all-rib/tcc/new-src/18-conclusao.tex

\chapter{Conclusão}\label{cap:conclusoeseperspectivas}

O sistema num geral apresentou diversos problemas, e cada um deles foi
abordado individualmente. O projeto portanto contribuiu de maneira
significativa para registro, e sugestão de abordagens para a
respectiva solução.

A plataforma estabelecida permite a integração de uma grande gama de
sensores, desde que utilizadores do protocolo I²C, e com uma
arquitetura compatível à biblioteca HERMES.

Além disso, os testes realizados, apesar de prematuros, evidenciou
falhas intrinsecas na forma de conexão dos sensores, bem como do
contato entre material orgânico e o hardware. Mais testes de
impermeabilização são necessários, bem como de diferentes aparatos para o correto
posicionamento, seja alterando a caixa, ou alterando o encapsulamento.

Todas as soluções foram documentadas e estão disponíveis publicamente
em repositório pessoal de \cite{Allan2025}.
