all-rib/tcc/new-src/19-referencias.tex

[1] Brown-2001 - Responding to Deforestation: Productive Conservation,
the World Bank, and Beekeeping in Rondonia, Brazil*

[2] https://abelha.org.br/atlas-da-apicultura-no-brasil/

[3] https://www.fao.org/faostat/en/#data/QCL

[4] machado-2024 - UTILIZAÇÃO DE TECNOLOGIA DE PRECISÃO NA APICULTURA:
UMA REVISÃO SISTEMATICA, PAULA ARAUJO MACHADO

[5]
http://apisenterprises.com/papers_htm/ABJ/Beekeeping%20in%20Brazil_full.htm

[6] Beginer's bee book  

[7] https://abelhas.org/Mapa?cd
https://abelha.org.br/abelhas-sem-ferrao-do-brasil/
[8]https://abelha.org.br/abelhas-e-producao-de-alimentos-no-brasil/
mapa de abelhas no brasil

[9] https://www.embrapa.br/meio-ambiente/abelhas-nativas/abelhas-e-plantas
Lista extensiva de de abelhas brasileiras, e curiosidades.

[10] http://dx.doi.org/10.7769/gesec.v13i3.1
Revista que mostra dados sobre apicultura

[11] https://www.sciencedirect.com/science/article/pii/S0304380013002895
Modelagem dinâmica de uma colmeia

[12] https://hackaday.io/project/1741-honeybee-hive-monitoring/details
Sujeito que monitorou o peso de uma colmeia

[13] https://lume.ufrgs.br/handle/10183/276197

artigo que revisa algumas coisas sobre AP

[14] https://www.grap.udl.cat/en/presentacio/que-fem/definicions-agricultura-de-precisio/

[15] https://www.i2c-bus.org/i2c-primer/common-problems/

[16] https://github.com/all-rib/hermes

[17] lilygo datasheet
https://github.com/Xinyuan-LilyGO/LilyGo-LoRa-Series:w

[18] https://docs.espressif.com/projects/esp-idf/en/stable/esp32/api-reference/system/log.html
	Lista de coisas sobre como funciona o log no esp32

[19] - https://cdn.sparkfun.com/datasheets/Sensors/Temp/DS18B20.pdf
datasheet ds18b20

[20] - https://sensirion.com/media/documents/213E6A3B/63A5A569/Datasheet_SHT3x_DIS.pdf
datasheet sht30

[21] - https://www.mouser.com/datasheet/2/758/DHT11-Technical-Data-Sheet-Translated-Version-1143054.pdf

datasheet dht11

[22] - https://invensense.tdk.com/wp-content/uploads/2015/02/INMP441.pdf

datasheet inmp441

[24] - https://www.bosch-sensortec.com/media/boschsensortec/downloads/datasheets/bst-bme280-ds002.pdf
datasheet bme280

[23] - https://www.nxp.com/docs/en/user-guide/UM10204.pdf
i2c specification
