all-rib/tcc/new-src/README.tex

Geralmente um TCC tem alguns capítulos bem definidos:

Introdução

Conceitos

Revisão de literatura/Trabalhos relacionados

Proposta

Metodologia

Experimento e Resultados

Conclusões
