all-rib/tcc/new-src/04-agradecimentos.tex

\begin{agradecimentos}

Obrigado à Deus pela oportunidade de realizar, ainda que incerto de quê.

Ao Francisco, meu avô. Os muros que ele levantou não cabem nessas folhas.

Aos meus orientadores, pela paciência monastérica do meu retorno.

À minha namorada, pela compreensão e apoio, piadas e broncas.

E aos meus amigos, à Ernane Carreira, e à todos os que não mencionei, fielmente lembrados em mente coração.

\end{agradecimentos}
