all-rib/tcc/new-src/05-epigrafe.tex

\begin{epigrafe}

%Espaço destinado à epígrafe (elemento opcional). Nesta folha, o(a) autor(a) usa uma citação, seguida de indicação de autoria e ano, relacionada, preferencialmente, com o assunto tratado no corpo do trabalho. A citação deverá constar na lista de referências. Exemplo: 
%
''Se é pra dois, ou três... Então é pra mim!'' \cite{Filho2021}.

%''Então... Não tem final da história...'' \cite{Candido2002}.

\end{epigrafe}
