all-rib/tcc/old-src/main.tex

%%%% main.tex, 2022/08/10, 2.5
%%%% Copyright (C) 2020 Vinicius Pegorini (vinicius@utfpr.edu.br)
%%
%% This work may be distributed and/or modified under the conditions of the
%% LaTeX Project Public License, either version 1.3 of this license or (at your
%% option) any later version.
%% The latest version of this license is in
%%   http://www.latex-project.org/lppl.txt
%% and version 1.3 or later is part of all distributions of LaTeX version
%% 2005/12/01 or later.
%%
%% This work has the LPPL maintenance status `maintained'.
%%
%% The Current Maintainer of this work is Vinicius Pegorini.
%%
%% This work consists of the files utfprpb.cls, utfprpb.tex, and
%% utfprpb-dados.tex.
%%
%% The Current Maintainer of this work is Vinicius Pegorini.
%% Updated by:
%% - Marco Aurélio Graciotto Silva;
%% - Rogério Aparecido Gonçalves;
%% - Luiz Arthur Feitosa dos Santos.
%%
%% This work consists of the files utfpr.cls, main.tex, and
%% variaveis.tex.
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

%###################################################

% Luiz - pdfa: inclusão do pdfa
\PassOptionsToPackage{
	pdfa
}{hyperref}

%% Classe e opções de documento
\documentclass[%% Opções
%% -- Opções da classe memoir --
  12pt,%% Tamanho da fonte: 10pt, 11pt, 12pt, etc.
  a4paper,%% Tamanho do papel: a4paper (A4), letterpaper (carta), etc.
  % fleqn,%% Alinhamento das equações à esquerda (comente para alinhamento centralizado)
  % leqno,%% Numeração das equações no lado esquerdo (comente para lado direito)
  oneside,%% Impressão dos elementos textuais e pós-textuais: oneside (anverso) ou twoside (anverso e verso, se mais de 100 p.)
  openright,%% Impressão da primeira página dos capítulos: openright (anverso), openleft (verso) ou openany (anverso e verso)
%% -- Opções da classe abntex2 --
  sumario = abnt-6027-2012,%% Formatação do sumário: tradicional (estilo tradicional) ou abnt-6027-2012 (norma ABNT 6027-2012)
  chapter = TITLE,%% Títulos de capítulos em maiúsculas (comente para desabilitar)
  % luiz - comentar section para ser minusculo
  %section = TITLE,%% Títulos de seções secundárias em maiúsculas (comente para desabilitar)
  % subsection = TITLE,%% Títulos de seções terciárias em maiúsculas (comente para desabilitar)
  % subsubsection = TITLE,%% Títulos de seções quartenárias em maiúsculas (comente para desabilitar),
%% -- Opções da classe utfprpgtex --
  pretextualoneside,%% Impressão dos elementos pré  -textuais: pretextualoneside (anverso) ou pretextualtwoside (anverso e verso)
  fontetimes,%% Fonte do texto: fontetimes (times), fontearial (arial) ou fontecourier (courier)
  % vinculoscoloridos,%% Cores nos vínculos (citações, arquivos, links, url, etc.) (comente para desabilitar)
  semrecuonosumario,%% Remoção do recuo dos itens no sumário (comente para adição do recuo, se estilo tradicional)
  usemakeindex,%% Compilação de glossários e índices utilizando makeindex (comente para desabilitar)
  % legendascentralizadas,%% Alinhamento das legendas centralizado (comente para alinhamento à esquerda)
  %aprovacaoestiloppg,%% Folha de aprovação do programa de pós-graduação no estilo do PPG (comente para estilo padrão)
  pardeassinaturas,%% Assinaturas na folha de aprovação em até duas colunas (comente para em uma única coluna)
  % linhasdeassinaturas,%% Linhas de assinaturas na folha de aprovação (comente para remover as linhas)
%% -- Opções do pacote babel --
  english,%% Idioma adicional para hifenização
  french,%% Idioma adicional para hifenização
  spanish,%% Idioma adicional para hifenização
  brazil,%% Idioma principal do documento (último da lista)
]{utfpr}%% Classe utfpr

% Luiz: pdfa: necessário para criar pdfa
\usepackage[a-3b,mathxmp]{pdfx}[2018/12/22] % você pode escolher entre a-1b, a-2b, a-3b - o template ainda não suporta o a-Xa de 

\input{configuracoes}

%% Arquivo de dados do modelo de documento LaTeX para produção de trabalhos acadêmicos da UTFPR
\input{./variaveis}%% Realize as modificações pertinentes no arquivo "utfprpb-dados.tex"

%% Ferramenta para criação de índices
\makeindex%% Não comente esta linha

%% Ferramenta para criação de glossários
\makeglossaries%% Não comente esta linha
\include{./PreTexto/entradas-siglas}%% Entradas da lista de abreviaturas e siglas - Comente para remover este item
\include{./PosTexto/entradas-glossario}%% Entradas do glossário - Comente para remover este item

%% Ferramenta para criação de nomenclaturas
\makenomenclature%% Não comente esta linha

%% Início do documento
\begin{document}%% Não comente esta linha

%% Formatação de páginas de elementos pré-textuais
\pretextual%% Não comente esta linha

%% Capa
%\incluircapa%% Comente para remover este item
\coverpageone

%% Folha de rosto (* coloca a ficha bibliográfica no verso)
%\incluirfolhaderosto*%% Comente para remover este item
\coverpagetwo

% luiz - iniciar contagem depois da folha de rosto
\clearpage
\setcounter{page}{2}

%% Ficha catalográfica (teses e dissertações)
%\incluirfichacatalografica%% Comente para remover este item

%% Errata
%\include{./PreTexto/errata}%% Comente para remover este item

%% Folha de aprovação
%\incluirfolhaaprovacao
\approvalpage
%\incluirfolhadeaprovacao%% Para adicionar no formato de texto
%\includepdf[scale=1.0,pages=1]{./PreTexto/folha-aprovacao.pdf} % para adicionar o pdf enviado pelo professor apenas substitua o documento folha-aprovacao.pdf dentro da pasta PreTexto

%% Dedicatória
\include{./PreTexto/dedicatoria}%% Comente para remover este item

%% Agradecimentos
\include{./PreTexto/agradecimentos}%% Comente para remover este item

%% Epígrafe
\include{./PreTexto/epigrafe}%% Comente para remover este item

%% Resumo
\include{./PreTexto/resumo}%% Comente para remover este item

%% Abstract
\include{./PreTexto/abstract}%% Comente para remover este item

%% Lista de algoritmos
%\incluirlistadealgoritmos%% Comente para remover este item

%% Lista de Ilustrações
%% Figuras, Gráficos, Quadros e Fotografias são incluídos juntos em uma mesma lista
%% Na UTFPR sugere-se adotar listas próprias, conforme a natureza da ilustração, a partir da existência de 3 elementos da mesma natureza.Neste caso, cada lista deverá iniciar em folha distinta. Não criar listas com apenas um item.

\incluirlistadeilustracoes

%% Lista de figuras
%\incluirlistadefiguras%% Comente para remover este item

%\incluirlistageraldeilustracoes
%\listofgeneralilust

%% Lista de Fotografias
%\incluirlistadefotografias %% Comente para remover este item

%% Lista de Gráficos
%\incluirlistadegraficos %% Comente para remover este item

%% Lista de tabelas
%\incluirlistadetabelas%% Comente para remover este item

%% Lista de quadros
%\incluirlistadequadros

%% Listagem de códigos fonte
%\incluirlistadecodigosfonte

%% Lista de abreviaturas, siglas e acrônimos
%\incluirlistadeacronimos{glossaries}%% Opções: "glossaries" (pacote) ou "file" (arquivo) ou "none" (desabilita)

%% Lista de símbolos
%\incluirlistadesimbolos{file}%% Opções: "nomencl" (pacote) ou "file" (arquivo) ou "none" (desabilita)

%% Sumário
\incluirsumario%% Comente para remover este item

%% Formatação de páginas de elementos textuais
\textual%% Não comente esta linha

%% Parte
% \part{Introdução}%% Comente para remover este item

%% Capítulo introdução - obrigatório
\include{./capitulos/cap-introducao}%% Comente para remover este item

%% Capítulo
\include{./capitulos/cap-conceitos}%% Comente para remover este item

%% Capítulo
\include{./capitulos/cap-trabalhos-relacionados}%% Comente para remover este item

%% Capítulo
\include{./capitulos/cap-proposta}%% Comente para remover este item

%% Capítulo
\include{./capitulos/cap-metodologia}%% Comente para remover este item

%% Capítulo
\include{./capitulos/cap-experimentos-resultados}%% Comente para remover este item

%% Capítulo - esse capítulo contém exemplos para melhor uso do modelo Latex
%% Na versão final do TCC esse capítulo deve ser removido utilizando o sinal %
%\include{./capitulos/cap-exemplo}%% Comente para remover este item

%% Parte
% \part{Conclusão}%% Comente para remover este item

%% Capítulo
\include{./capitulos/cap-conclusoes}%% Comente para remover este item

%% Capítulos após este comando criam marcadores do pdf na raiz
% \phantompart%% Comente para remover este item

%% Formatação de páginas de elementos pós-textuais
\postextual%% Não comente esta linha

%% Arquivos de referências
\arquivosdereferencias{%% Arquivos bibtex sem a extensão .bib e separados por vírgula - Não comente esta linha
  %./PosTexto/exemplos-referencias,%% Arquivo de referências - Comente para remover este item
  main%% Arquivo de referências - Comente para remover este item
}%% Não comente esta linha

%% Glossário
%\incluirglossario %% Comente para remover este item

%% Arquivos de apêndices
 \begin{arquivosdeapendices}%% Os arquivos de apêndices devem se incluídos neste ambiente - Não comente esta linha
%   %\partapendices%% Página de início dos apêndices - adiciona uma página com o título Apêndices
%   %% Capítulo de exemplo
   \include{./PosTexto/apendicea}%% Apêndice - Comente para remover este item
   \include{./PosTexto/apendiceb}%% Apêndice - Comente para remover este item
 \end{arquivosdeapendices}%% Não comente esta linha

% \begin{apendicesenv}%% Ambiente apendicesenv

% \partapendices
% \chapter{Ola}

% \lipsum[55-56]

% \end{apendicesenv}

%% Arquivos de anexos
\begin{arquivosdeanexos}%% Os arquivos de anexos devem se incluídos neste ambiente - Não comente esta linha
  %\partanexos%% Página de início dos anexos - adiciona uma página com o título Anexos

  \include{./PosTexto/anexoa}%% Anexo - Comente para remover este item
  \include{./PosTexto/anexob}%% Anexo - Comente para remover este item
\end{arquivosdeanexos}%% Não comente esta linha

%% Índice - Adiciona um índice remissivo.
%\incluirindice%% Comente para remover este item

%% Fim do documento
\end{document}%% Não comente esta linha
