all-rib/tcc/old-src/PreTexto/dedicatoria.tex

%%%% DEDICATÓRIA
%%
%% Texto em que o autor presta homenagem ou dedica seu trabalho.

\begin{dedicatoria}%% Ambiente dedicatoria

%Espaço destinado à dedicatória (elemento opcional). Folha que contém o oferecimento do trabalho à determinada pessoa ou pessoas. Exemplo:

Dedico este trabalho à Deus, e à minha família, à minha namorada, e amigos.

\end{dedicatoria}
