all-rib/tcc/old-src/figuras/foto1-eps-converted-to.pdf

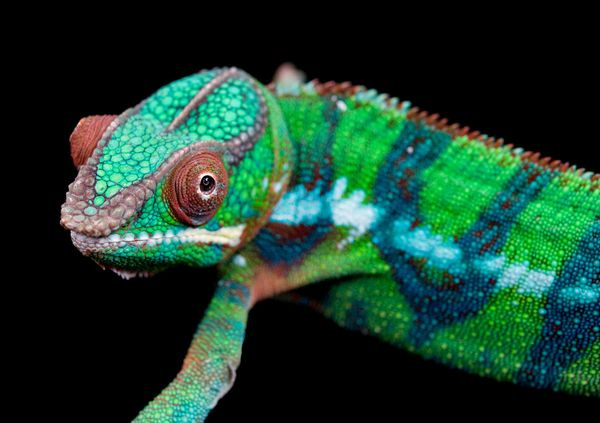
[picture p2: page 1]
