all-rib/tcc/old-src/figuras/grafico2-eps-converted-to.pdf

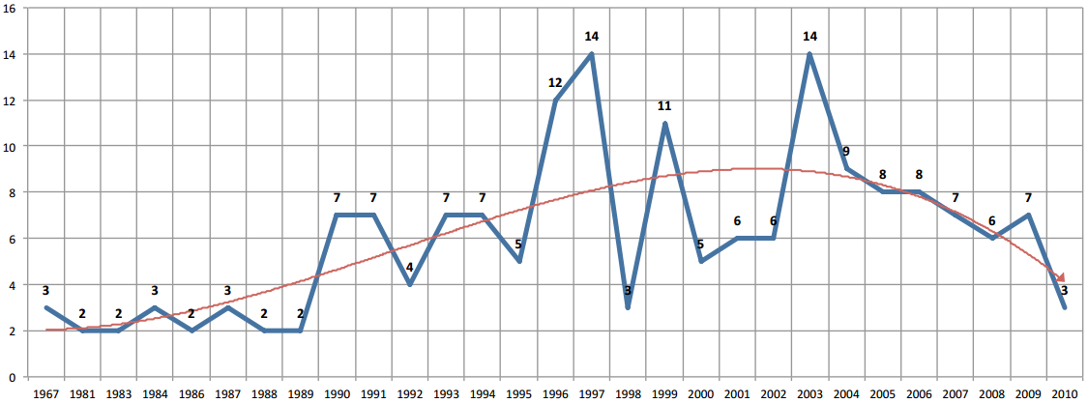
[picture p3: page 1]
