all-rib/tcc/old-src/PreTexto/arquivos/licencasCC/by-eps-converted-to.pdf

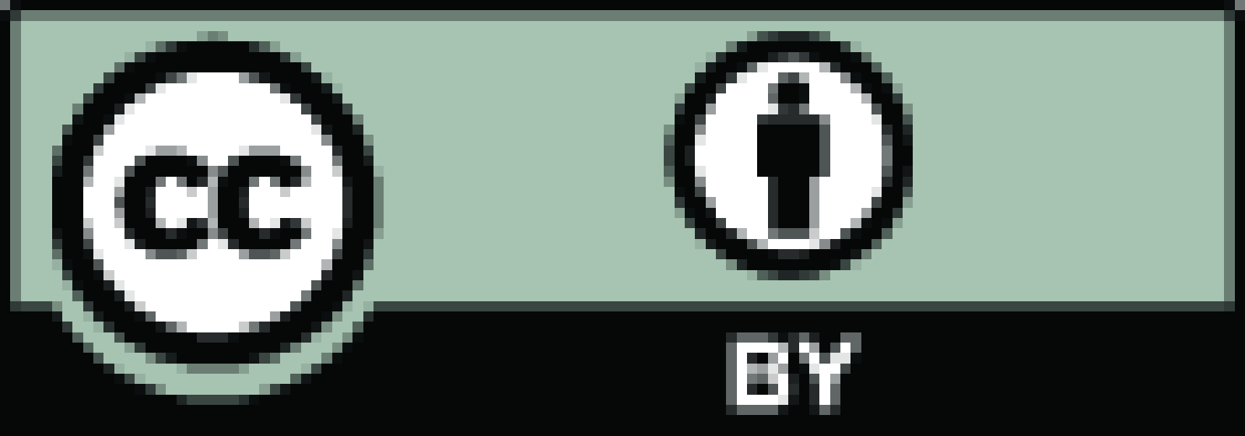
[picture p4: page 1]
