all-rib/tcc/docs/angustula.JPG

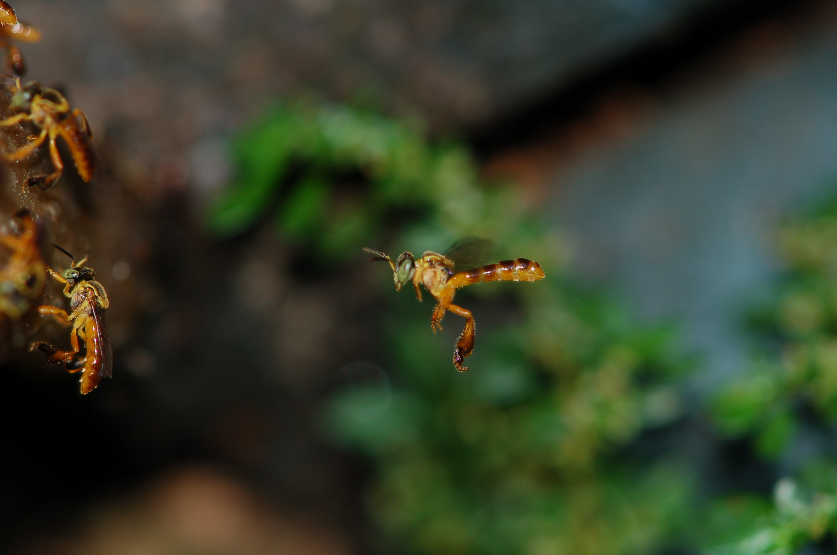
docs/angustula.JPG
