all-rib/tcc/docs/arquitetura.png

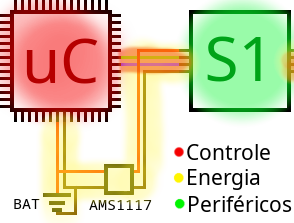
docs/arquitetura.png
