all-rib/tcc/docs/bme280.png

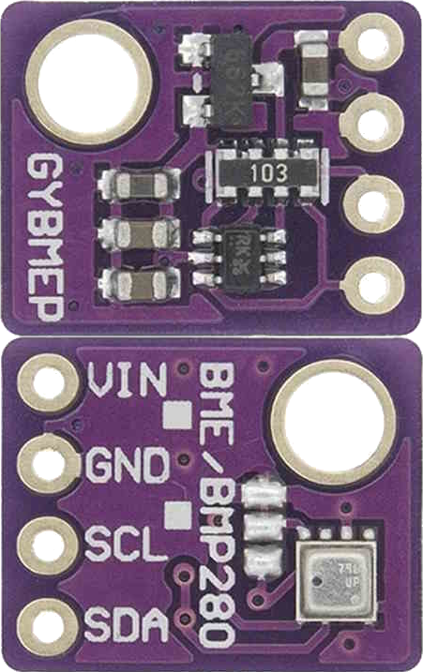
docs/bme280.png
