all-rib/tcc/docs/dht11.png

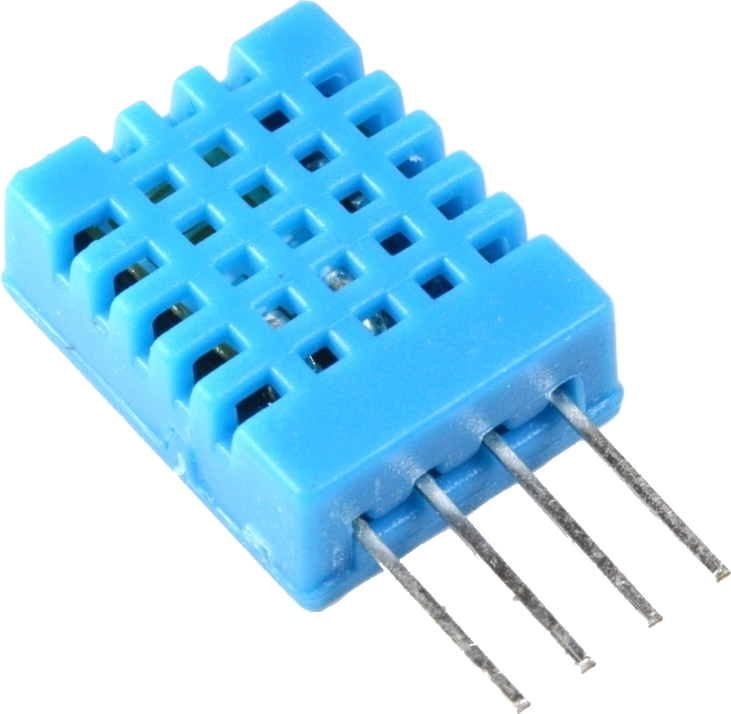
docs/dht11.png
