all-rib/tcc/docs/ds18b20.png

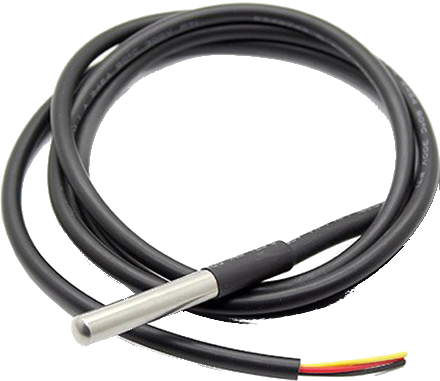
docs/ds18b20.png
