all-rib/tcc/docs/hermes.png

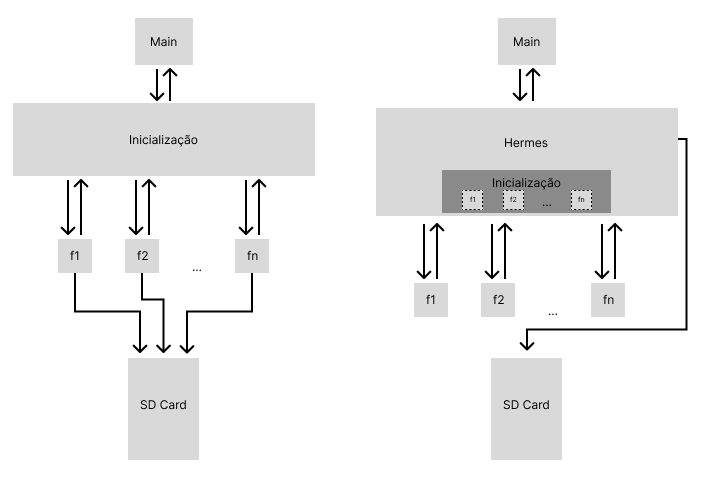
docs/hermes.png
