all-rib/tcc/docs/i2c-1.png

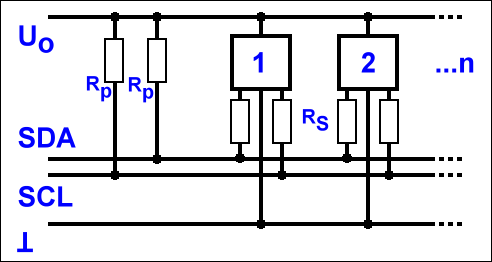
docs/i2c-1.png
