all-rib/tcc/docs/inmp441.png

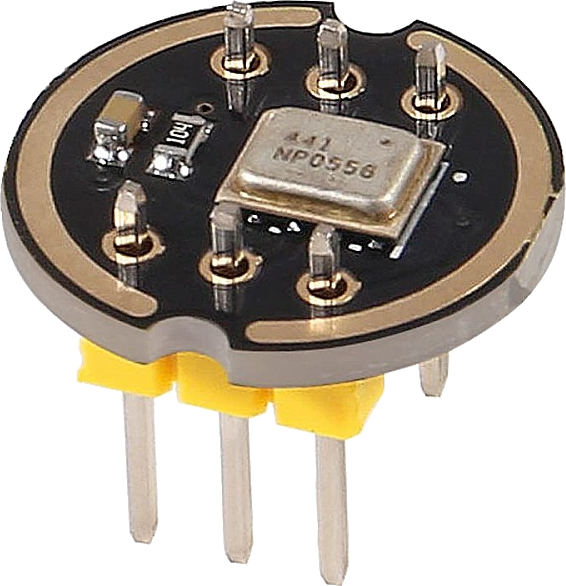
docs/inmp441.png
