all-rib/tcc/docs/jatai.png

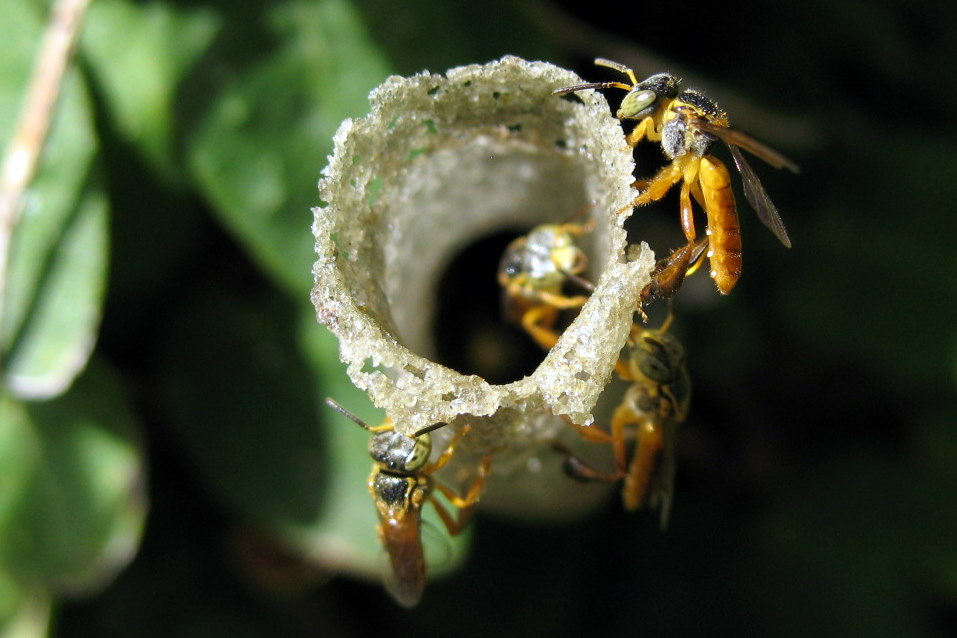
docs/jatai.png
