all-rib/tcc/docs/lora32.png

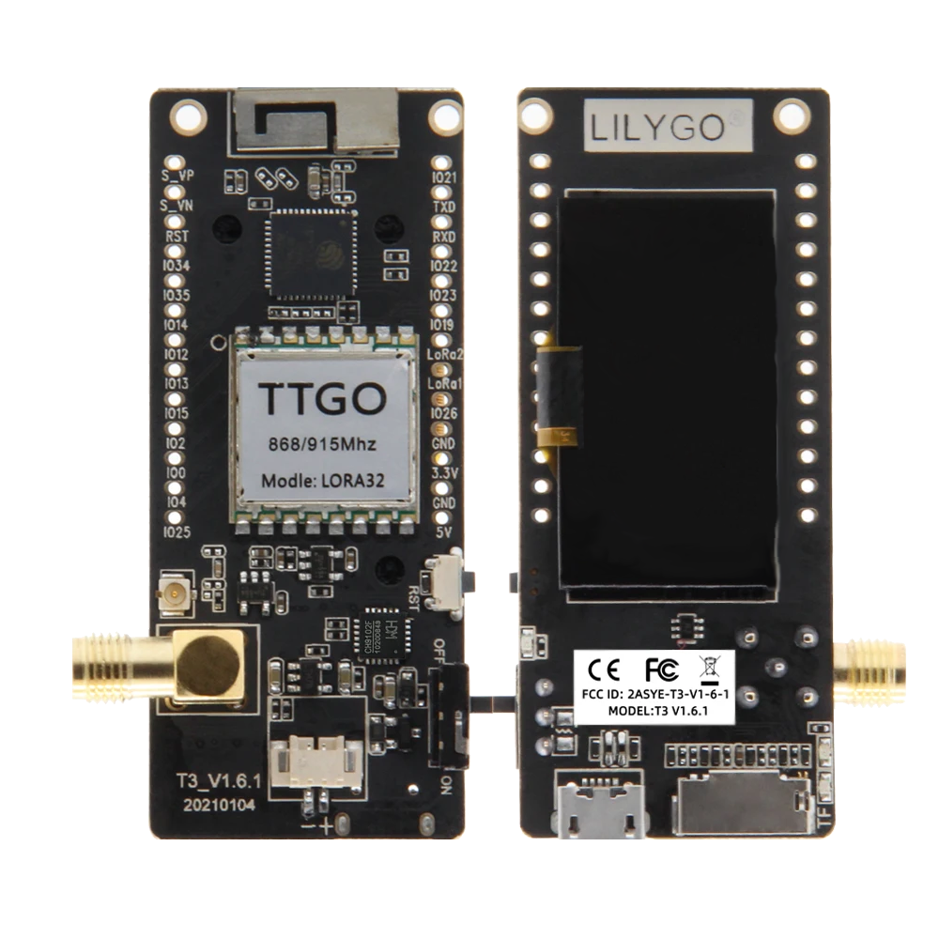
docs/lora32.png
