all-rib/tcc/docs/sen-cob.png

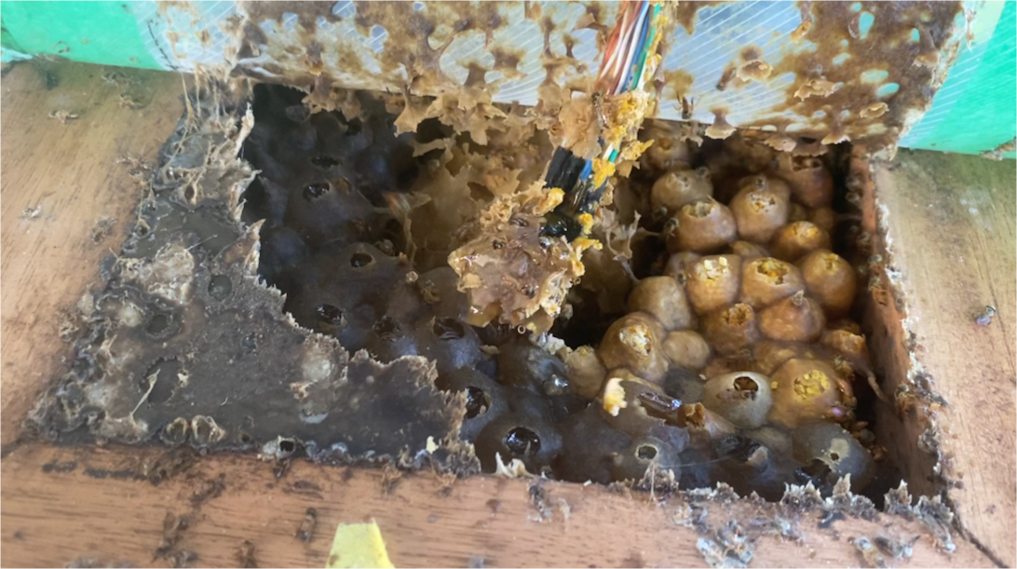
docs/sen-cob.png
