all-rib/tcc/docs/sht30.png

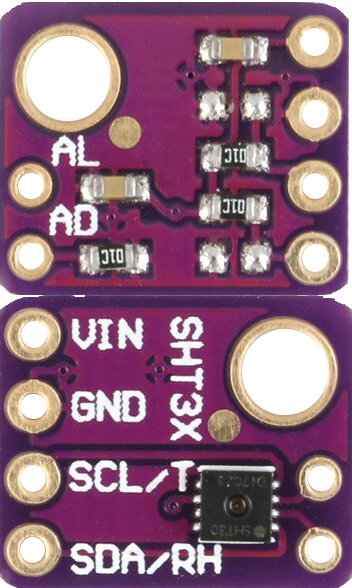
docs/sht30.png
