all-rib/tcc/docs/topologia.png

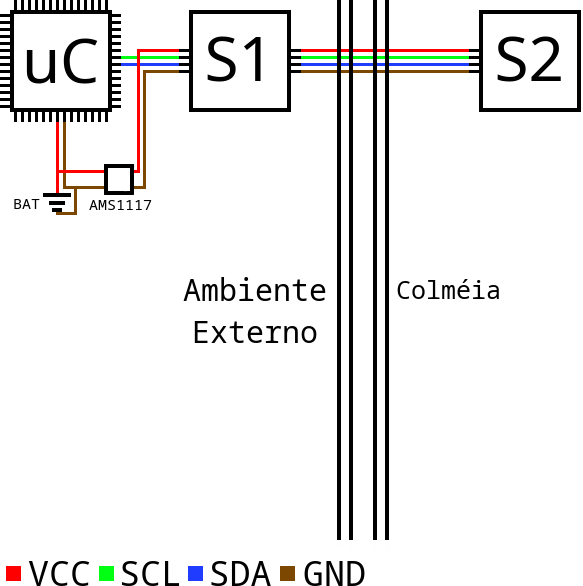
docs/topologia.png
