all-rib/tcc/midia/ilustracao fila.jpg

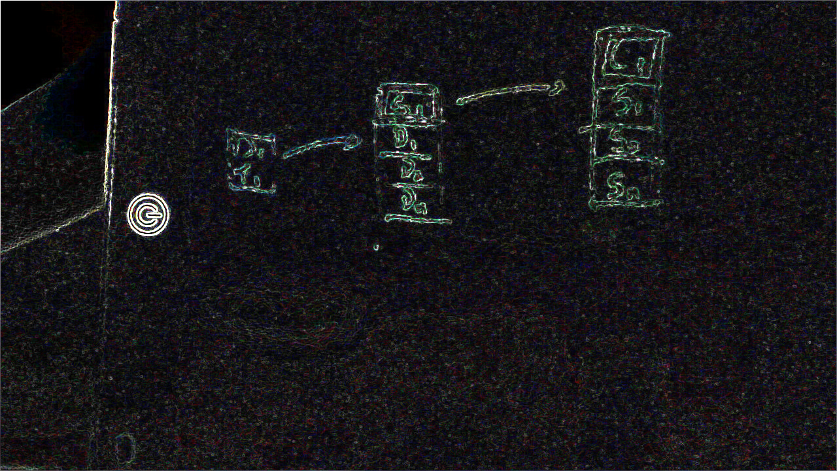
midia/ilustracao fila.jpg
