all-rib/tcc/midia/Tcc/1 - colmeia 2.JPG

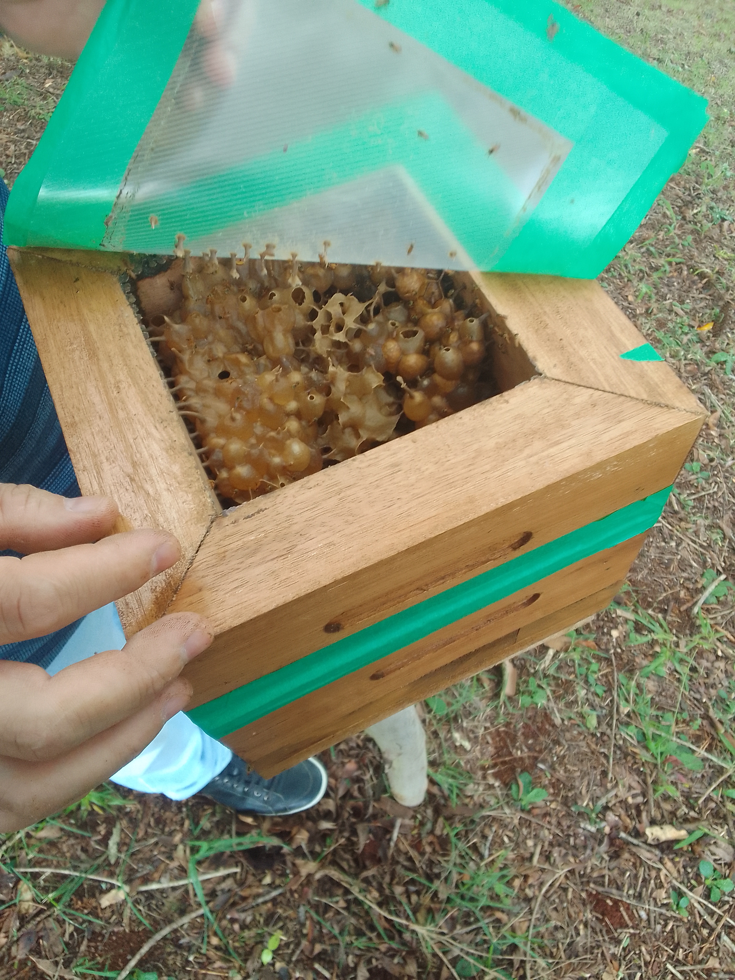
midia/Tcc/1 - colmeia 2.JPG
