all-rib/tcc/midia/Tcc/1 - colmeia 3.JPG

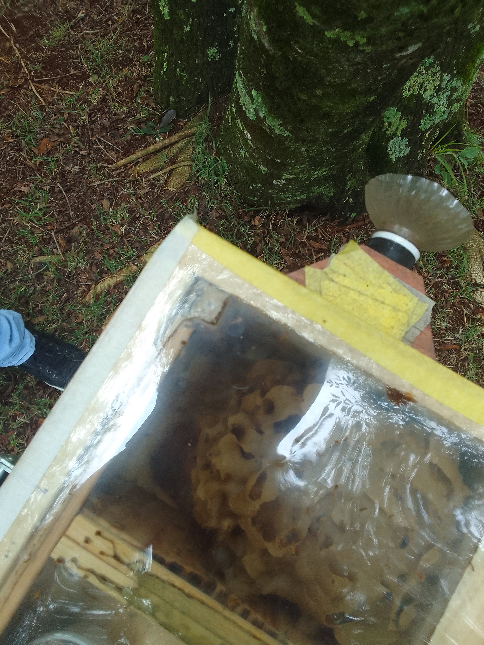
midia/Tcc/1 - colmeia 3.JPG
