all-rib/tcc/midia/Tcc/1 - colmeia 4.JPG

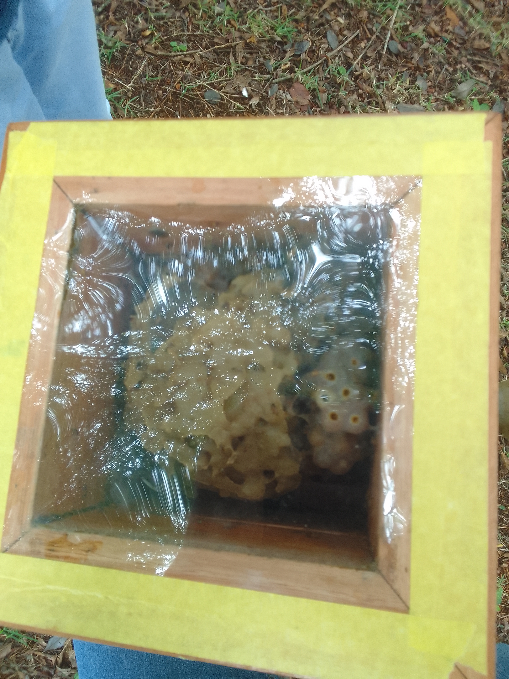
midia/Tcc/1 - colmeia 4.JPG
