all-rib/tcc/midia/Tcc/1 - colmeia 6.JPG

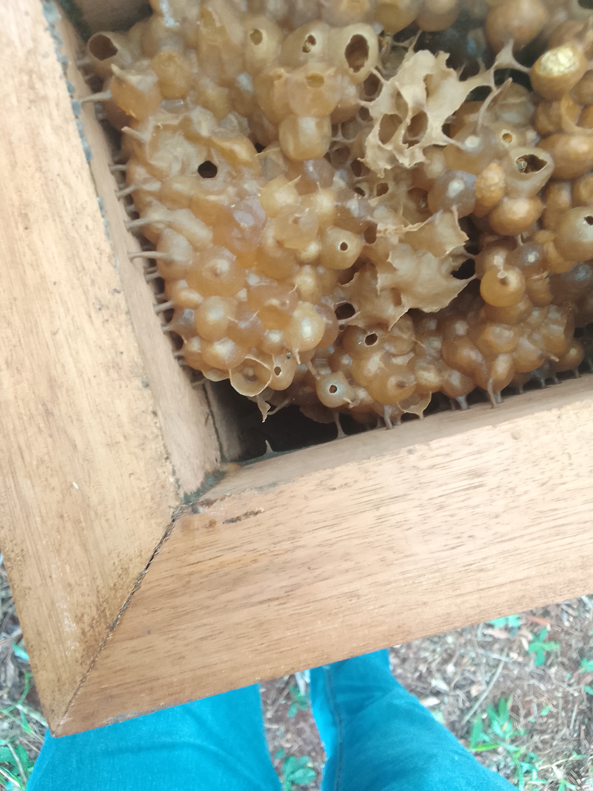
midia/Tcc/1 - colmeia 6.JPG
