all-rib/tcc/midia/Tcc/1 - conector.JPG

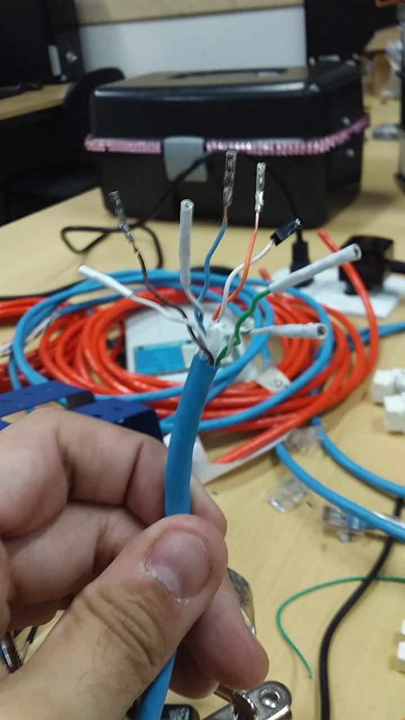
midia/Tcc/1 - conector.JPG
