all-rib/tcc/midia/Tcc/1 - lora.JPG

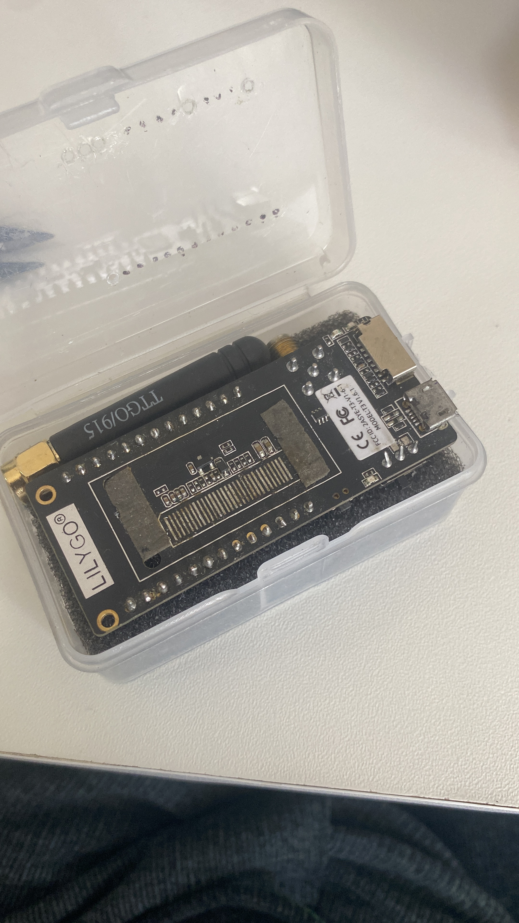
midia/Tcc/1 - lora.JPG
