all-rib/tcc/midia/Tcc/2 - colmeia 1.png

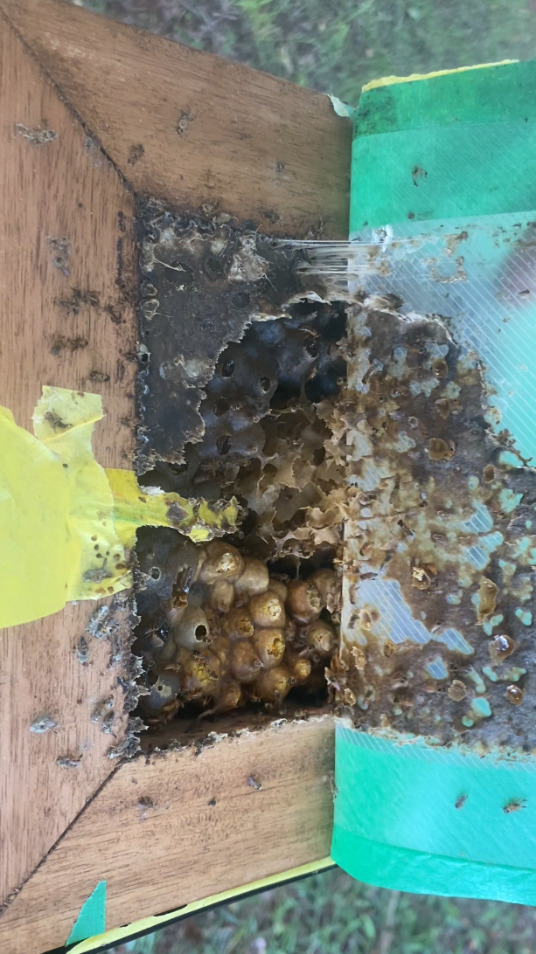
midia/Tcc/2 - colmeia 1.png
