all-rib/tcc/midia/Tcc/2 - sensor 3.png

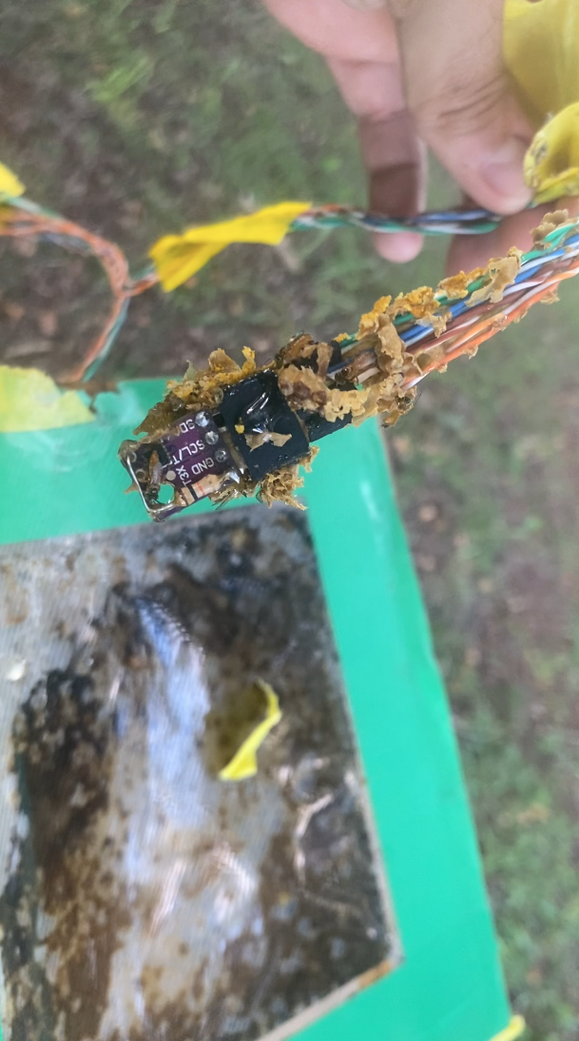
midia/Tcc/2 - sensor 3.png
