all-rib/tcc/midia/Tcc/2 - sensor 4.png

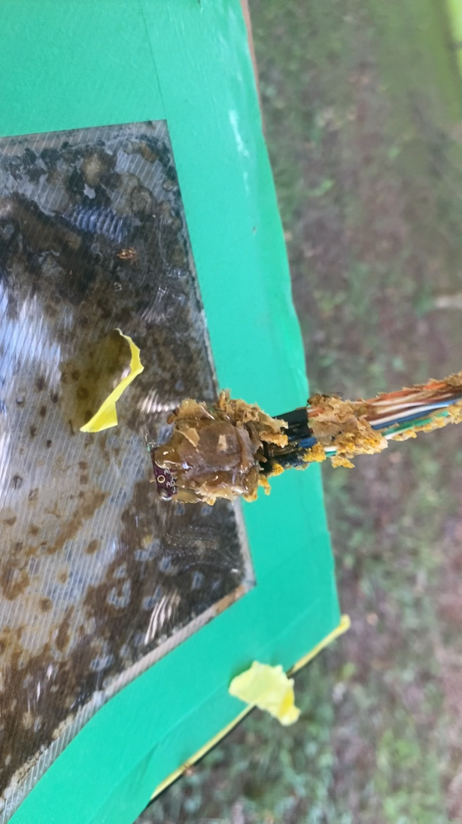
midia/Tcc/2 - sensor 4.png
