all-rib/tcc/midia/Tcc/2 - sensor 5.png

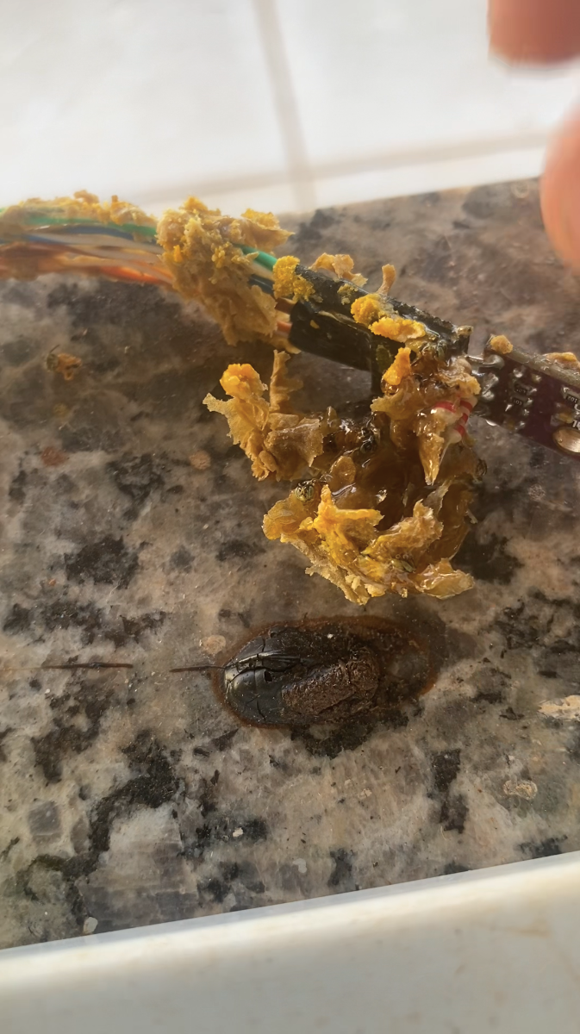
midia/Tcc/2 - sensor 5.png
