all-rib/tcc/midia/Tcc/2 - sensor 6.png

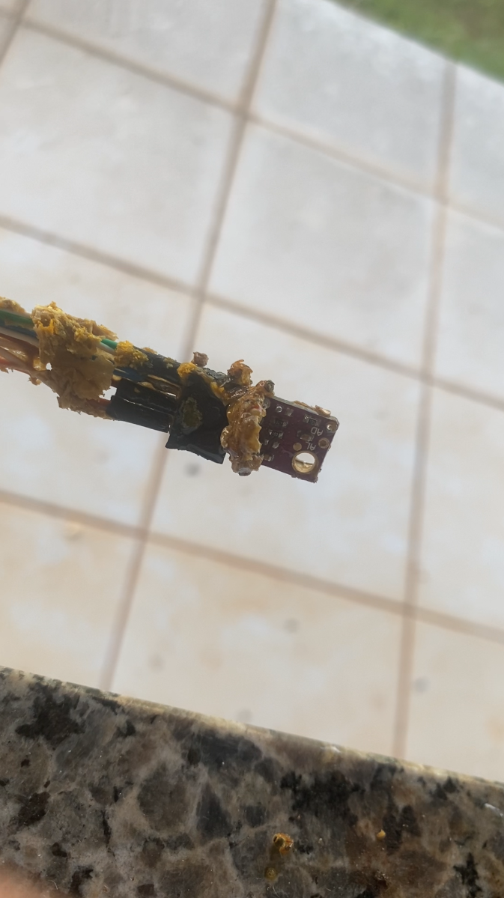
midia/Tcc/2 - sensor 6.png
