all-rib/tcc/midia/Tcc/2 - sistema 2.png

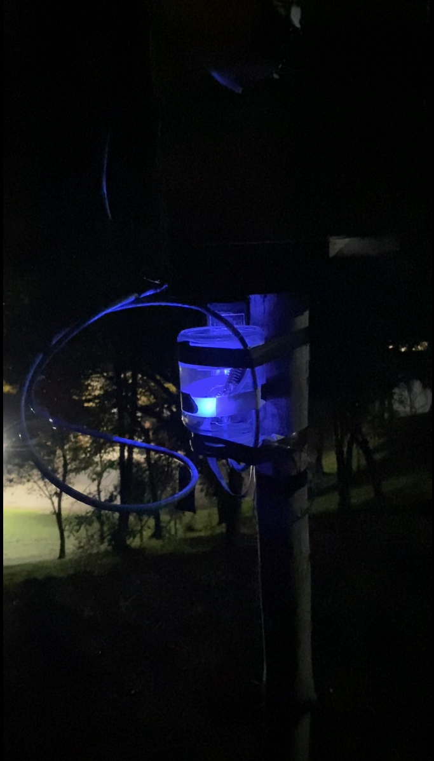
midia/Tcc/2 - sistema 2.png
