all-rib/tcc/midia/Tcc/IMG_0256.JPG

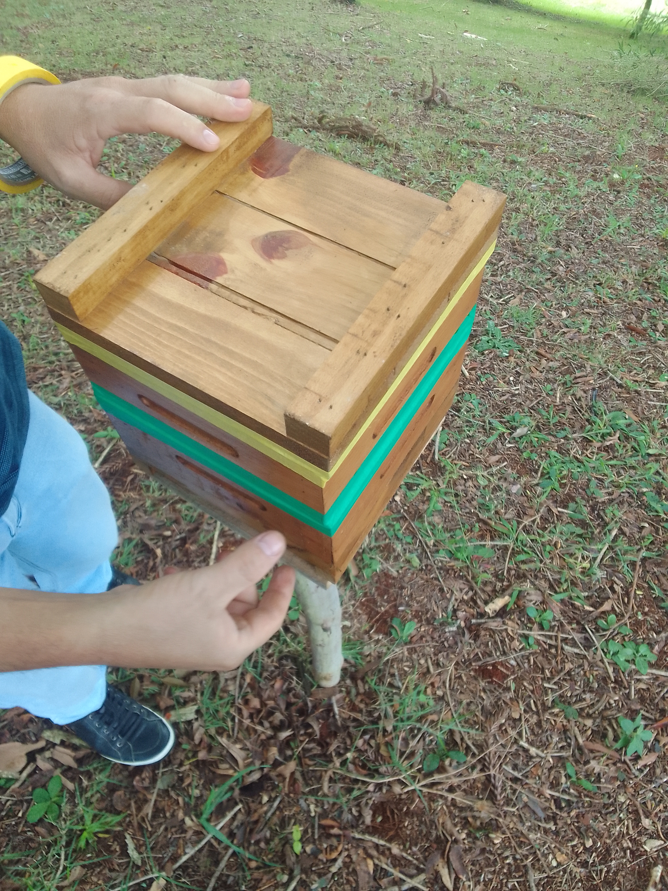
midia/Tcc/IMG_0256.JPG
