all-rib/tcc/midia/Tcc/IMG_0266.JPG

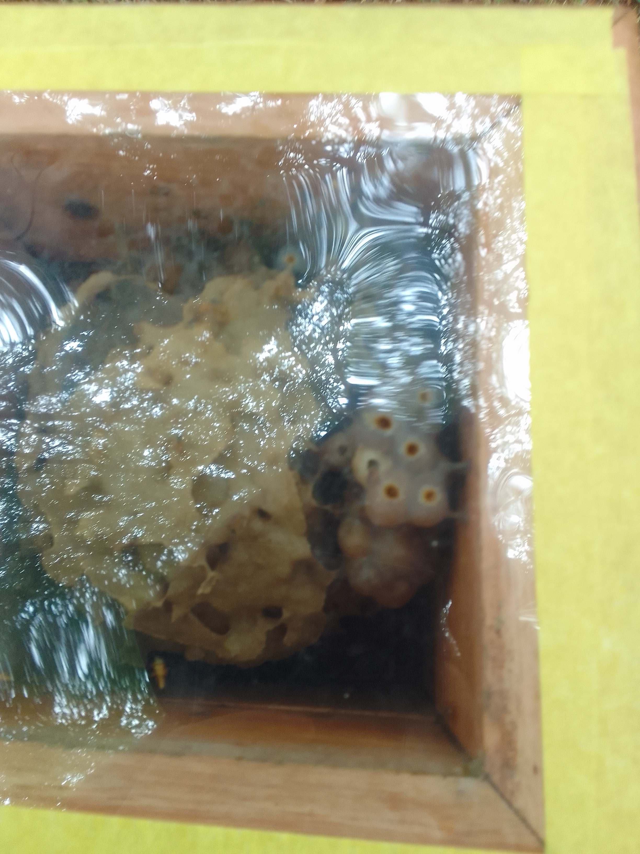
midia/Tcc/IMG_0266.JPG
