all-rib/tcc/midia/Tcc/IMG_0271.JPG

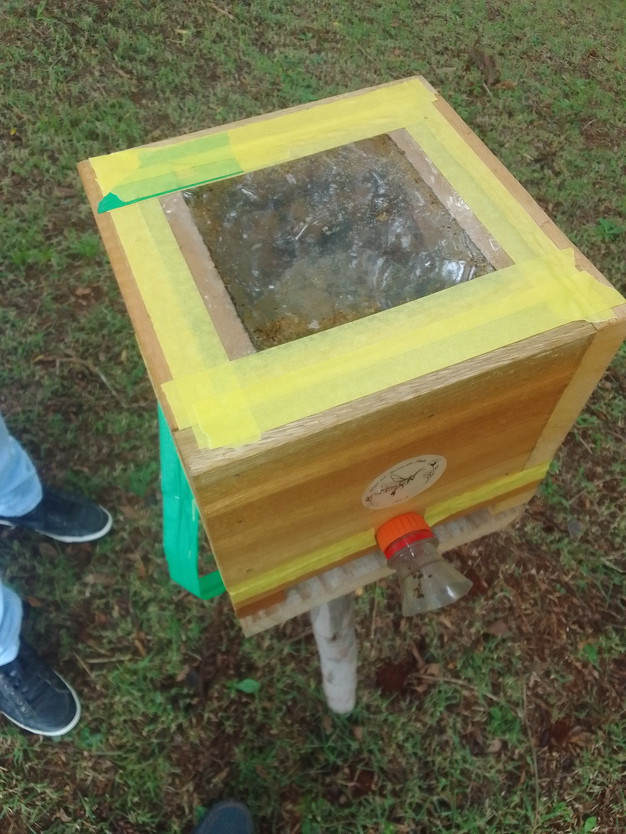
midia/Tcc/IMG_0271.JPG
