all-rib/tcc/midia/Tcc/IMG_0296.JPG

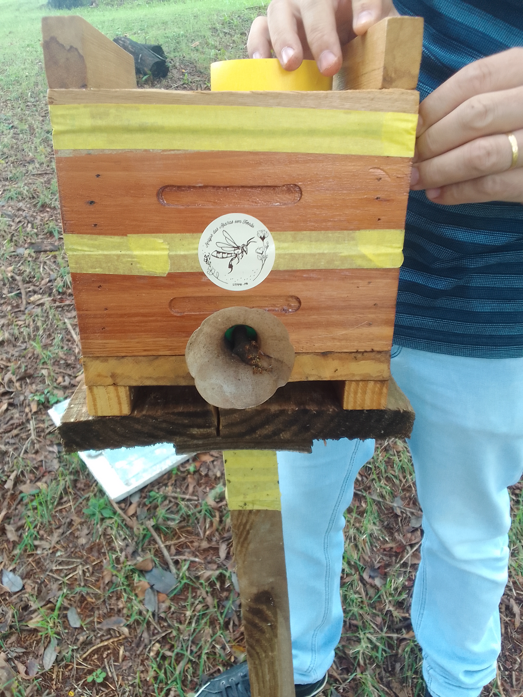
midia/Tcc/IMG_0296.JPG
