all-rib/tcc/midia/Tcc/IMG_0314.JPG

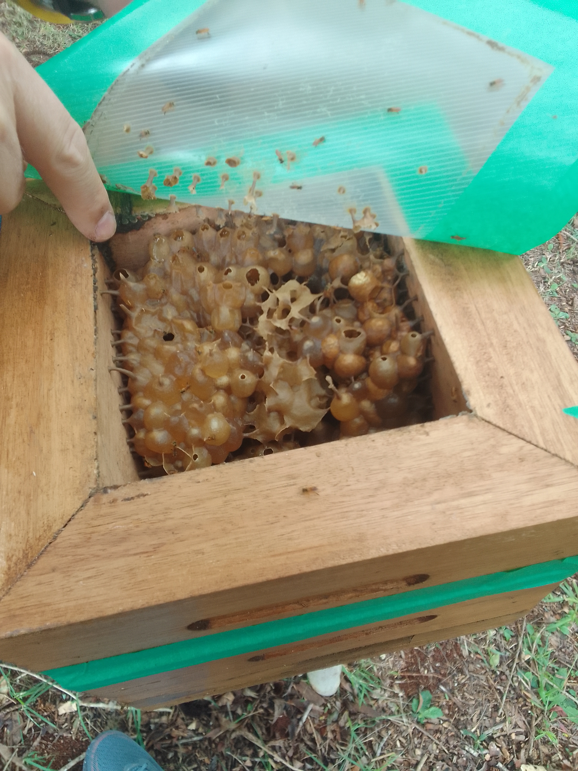
midia/Tcc/IMG_0314.JPG
