all-rib/tcc/midia/Tcc/IMG_0325.JPG

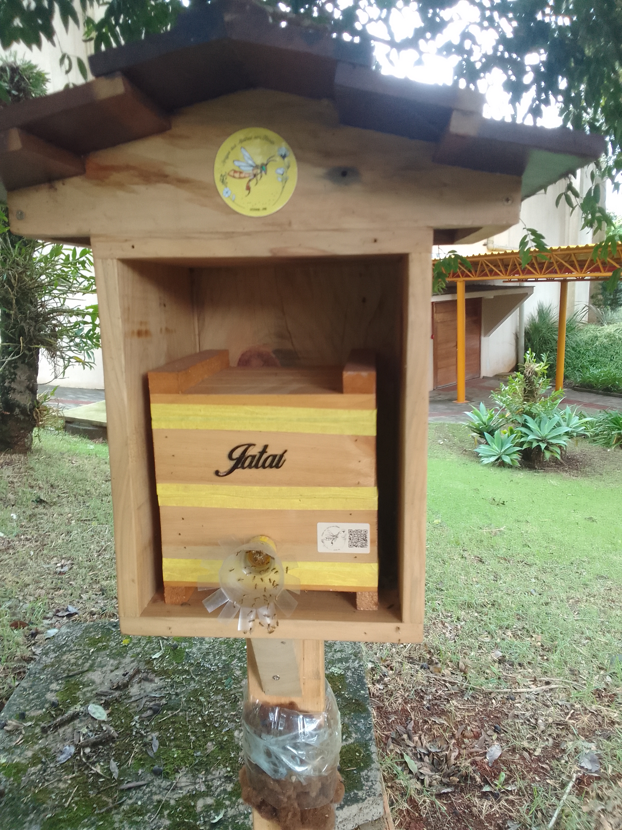
midia/Tcc/IMG_0325.JPG
