all-rib/tcc/midia/Tcc/IMG_0327.JPG

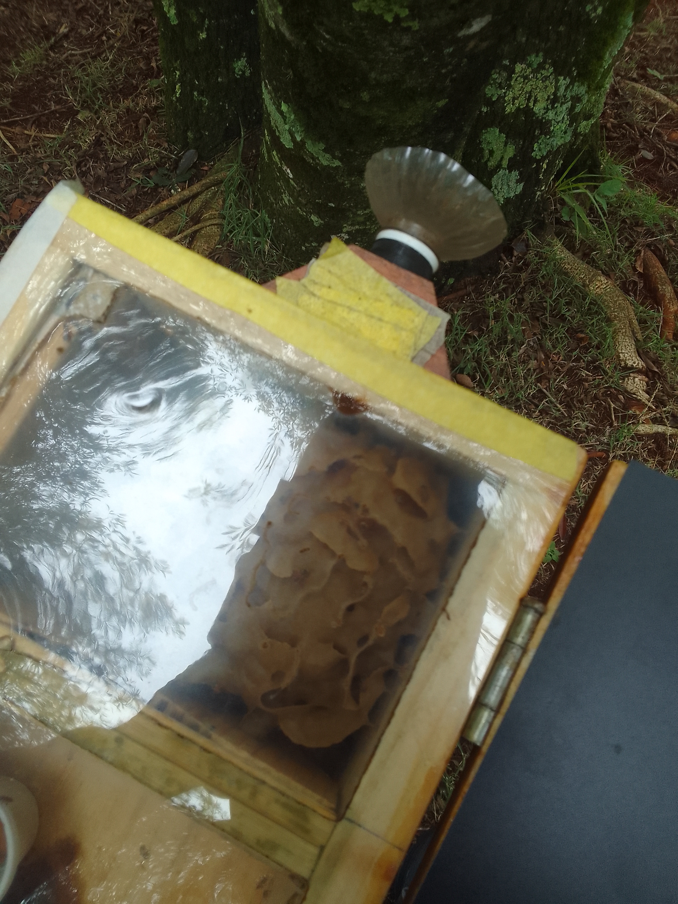
midia/Tcc/IMG_0327.JPG
