all-rib/tcc/midia/Tcc/IMG_0329.JPG

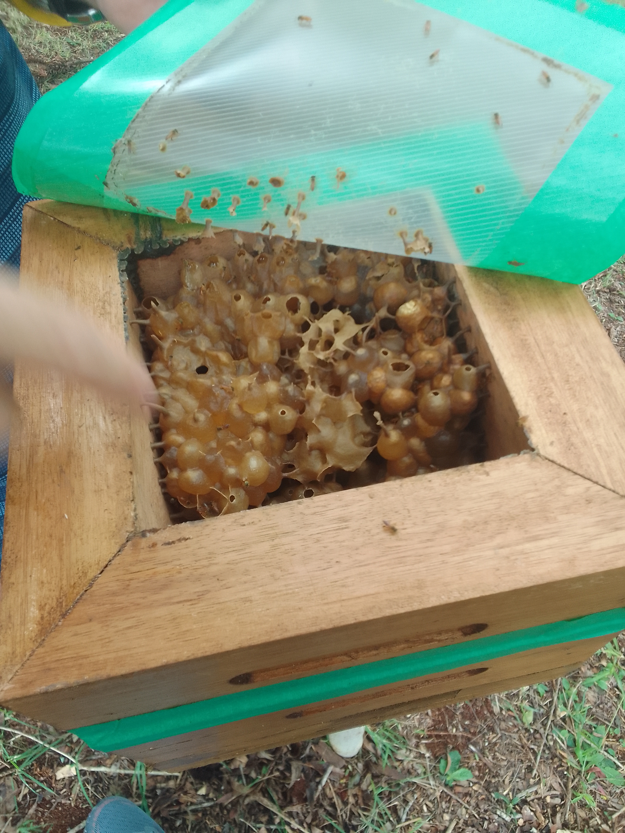
midia/Tcc/IMG_0329.JPG
