all-rib/tcc/old-src/capitulos/cap-experimentos-resultados.tex

/home/lab/std/tcc/tcc2/new-src/16-desenvolvimento.tex
