all-rib/tcc/old-src/PreTexto/errata.tex

%%%% ERRATA
%%
%% Lista dos erros ocorridos no texto, seguidos das devidas correções.

%\begin{errata}%% Ambiente errata
%\begin{table*}[htb]%% Ambiente table
%\begin{tabularx}{\textwidth}{|l|l|X|X|}%% Ambiente tabularx
%\hline
%\textbf{Página(s)}         & \textbf{Linha(s)} & \textbf{Onde se lê} & \textbf{Leia-se}         \\ \hline
%\pageref*{errata:capitulo} & 4, 9-11, 14-16    & capítulo(s)         & seção(ões) primária(s)   \\ \hline
%\pageref*{errata:secao}    & 12-16             & seção(ões)          & seção(ões) secundária(s) \\ \hline
%\pageref*{errata:subsecao} & 16                & subseção(ões)       & seção(ões) terciária(s)  \\ \hline
%\end{tabularx}
%\end{table*}
%\end{errata}
