all-rib/tcc/(commit log)

2025-01-23 Adicionado definição de agricultura de precisão
    [aristeu.kicad_pcb, aristeu.kicad_sch]
2025-03-12 ajuste de paragrafos
2025-03-14 Revisão de literatura "terminada"
2025-06-01 Adicionado texto sobre tipos de caixas
2025-06-06 to pegando no sono ja. Texto sobre sensores
2025-06-13 fuck this git limit of filesize
    [aristeu.kicad_pcb, aristeu.kicad_sch]
2025-06-22 Added honeycomb images
    [aristeu.kicad_pcb, aristeu.kicad_sch]
2025-11-08 Added brief data on sensors
2025-11-09 Added image on sensors and references of datasheet, and i2c specification
2025-11-09 Remade Materials and methods text
2025-11-10 Inserted some soft links for updating UTFPR LaTeX template
2025-11-10 teste de ci para compilar tcc
