all-rib/tcc/(notices)

Notices in the files:
old-src/capitulos/cap-exemplo.tex:
lizar&id_documento=1811618&id_orgao_publicacao=0}{nº 01/2020 COGEP-COPPG}, os trabalhos de conclusão de curso da \gls{utfpr} devem adotar uma licença Creative Commons, sendo que o texto das possíveis licenças pode ser visto em: \url{https://creativecommons.org/licenses/?lang=pt_BR}.
