all-rib/tcc/midia/Tcc/1 - colmeia 1.JPG

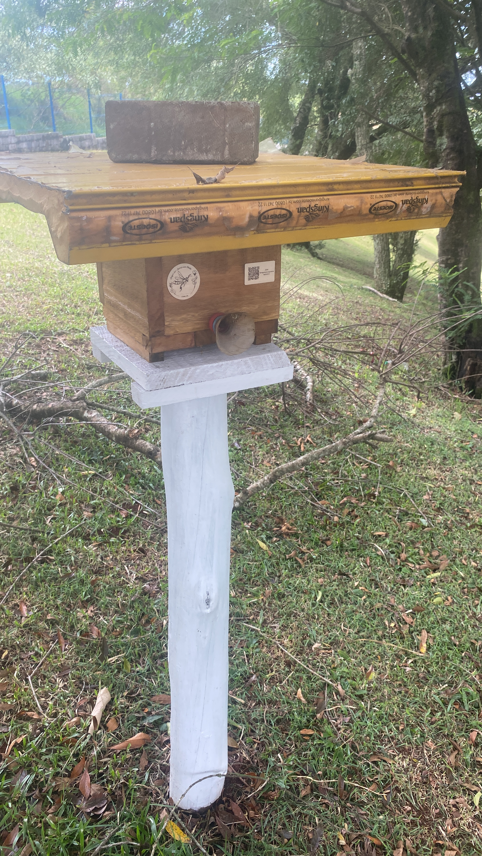
midia/Tcc/1 - colmeia 1.JPG
